mikavj/open-adaptive-switch/README.md

# Open Adaptive Switch

DIY wireless switches for iOS Switch Control, built around the Seeed XIAO
nRF52840. Each unit is a single button in a box: press it and it sends a
keystroke over Bluetooth LE, which an iPhone or iPad treats as an
accessibility switch input. The parts cost roughly $15 per unit;
comparable commercial Bluetooth switches sell for around $200.

The project started as a way to give a child with a motor disability an
affordable button for cause-and-effect games. A family can set everything
up from a phone: which key the button sends, one action or three, how
long before it sleeps, its name, and firmware updates. No computer, no
reflashing.

This is a work in progress. The firmware and configuration tools work;
enclosure designs, photos, and wiring diagrams are still to come.

## Hardware

| Part | Notes |
|---|---|
| Seeed XIAO nRF52840 | the plain variant, about $10; the Sense variant works identically |
| Tactile momentary button | wired between D0 and GND, no resistor needed |
| 3.7V 250mAh LiPo | JST connector, charged at 50mA over USB-C |
| Enclosure | can fit inside an existing adaptive switch, or check back for the 3D printed design in development |

Why this board: a BLE switch has to hold its connection all day on a
small battery. The nRF52840 does that at roughly 0.1mA, which means
months per charge; an ESP32 in its best buildable configuration draws
about twenty times more and would need charging every few days. The
whole wireless-keyboard community settled on this chip for the same
reason.

The switch works by advertising as a BLE HID keyboard. iOS pairs with it
through Settings, Accessibility, Switch Control, where any key from an
external keyboard can be assigned to a switch action. The firmware
defaults to F13, which nothing else on the system uses, so several
switches can be paired at once without colliding.

## Setting up a switch

Configuration happens over Bluetooth, from either of two clients:

**The config page**, at
[mikavj.github.io/open-adaptive-switch](https://mikavj.github.io/open-adaptive-switch/)
(source in [docs/](docs/)). Open it in Chrome or Edge on a computer or
Android device and tap Connect. On an iPhone or iPad, install the free
[Bluefy browser](https://apps.apple.com/app/id1492822055) first, then
open the page inside it - Safari does not support Web Bluetooth, and a
link into Bluefy does nothing until the app is installed. The page also
installs firmware updates and puts the first firmware on a blank board,
straight over Bluetooth. A QR code pointing at the page is in
[docs/qr](docs/qr), sized to print on the bottom of an enclosure.

**The iOS app**, in [app/](app/). A native SwiftUI app with the same
controls plus built-in firmware updates. It is not on the App Store yet;
building it yourself takes Xcode and an Apple developer account (see
[app/README.md](app/README.md)).

Either client can change:

| Setting | Choices |
|---|---|
| Mode | single key; tap or hold (two actions); short, medium, long press (three actions) |
| Keys | any HID keycode plus modifiers, per action |
| Sleep timer | minutes of inactivity before deep sleep, 0 to disable |
| Name | how the switch appears in Bluetooth lists; up to 15 plain characters |
| Status light | red, green, or blue accent |

Both show battery percentage, voltage, and charging state live, and check
this repository for firmware releases. Settings live on the switch
itself and survive restarts and updates. The switch accepts two
connections at once, so it can stay paired to the iPad while a parent
adjusts settings from a phone.

The chooser in the config page and the app only lists Open Adaptive
Switch devices (they filter on the switch's service identity), so
headphones and other Bluetooth devices never appear.

## Pairing with an iPhone or iPad

Settings, Accessibility, Switch Control, Switches, Add New Switch,
External, then press the button and assign an action.

Each distinct key registers as a separate switch input, so three-action
mode becomes three assignable switches from one physical button.

Two setups that work well in practice:

- Tap-anywhere games (tested with Peekaboo Barn): create a Switch Control
  Recipe with the action "Tap Middle of Screen" and timeout off, then
  launch the recipe. A press becomes a single screen tap with no scanner
  UI in the way.
- YouTube / Apple Music play-pause: leave Switch Control off entirely,
  set the switch to send Space, and pair it as a plain Bluetooth
  keyboard. Space toggles playback without bringing up the player
  controls.

If you reflash or rename a switch that was already paired, make iOS
Forget Device first, then pair again.

## Firmware updates

Three ways, most convenient first:

1. **Wireless, from the config page or app.** Both install updates
   directly: put the switch into update mode and the same page or app
   sends it the new firmware. Both can also flash a blank board ("Set
   up a new board"), so a switch can be built and updated without a
   computer. The blank-board flow is still experimental: some fresh
   factory boards refuse the wireless first flash. If yours does, put
   the first firmware on over USB (option 2) and update wirelessly from
   then on. A brand-new XIAO arrives running a factory demo that
   cycles the LED red, blue, green and has no Bluetooth at all;
   double-tap its reset button and the cycling stops - the LED may
   look off, which is normal - and the board is ready for "Set up a
   new board". It appears only in that flow, not in the regular switch
   list or in iOS Bluetooth settings. Nordic's free
   [nRF Device Firmware Update](https://apps.apple.com/app/id1624454660)
   app works too, with the release .zip.
2. **Any computer, no software.** Download the release .uf2, double-tap
   the switch's reset button, and a USB drive appears. Drag the file
   onto it; the switch reboots updated. (The copy dialog may report an
   error at the end - that's the drive vanishing on reboot, and the
   update still succeeded.)
3. **Wired, with the toolchain.** `./flash.sh` - it offers to install
   its own toolchain the first time it runs on a machine; see
   [SETUP.md](SETUP.md). For development and recovery; a new board can
   be set up wirelessly instead (option 1).

Settings survive all three. Releases carry the .zip and .uf2, built by
`./make_release.sh`.

## Battery

Charging is handled entirely by the XIAO's onboard BQ25101 charger IC:
50mA (a gentle 0.2C for the 250mAh cell), 4.20V termination, fixed in
hardware. A cell that measures 4.15 to 4.20V after charging is full and
healthy - 4.2V is the normal full-charge voltage for a LiPo cell.

The firmware samples the cell through the onboard divider, maps voltage
to percentage with a resting-voltage discharge table (the approach ZMK
and Meshtastic use), and reports it over the standard BLE Battery
Service - so it shows in the iOS Batteries widget - and in detail on the
config page and app. It is also put in the Bluetooth advertisement, so
the app can show a level in its device list before connecting.

Charging state comes from the charger IC's status pin, not guessed from
voltage; while charging, the percentage is capped at 99 because a
charging cell's voltage says nothing reliable about fill level. A charged
cell is held at 100 until it relaxes below 4.05V, so unplugging a full
switch doesn't drop the number. The displayed percent falls at most two
points per sample, so the inflated charging reading eases down to the
true resting value after unplugging instead of jumping, and radio-sag
transients can't make it bounce. The LED warns too: solid red below
3.55V, blinking red below 3.35V.

The firmware also protects the cell itself. If the smoothed voltage
stays below 3.30V for three consecutive samples (about a minute) while
nothing is charging, the switch blinks red and enters the same deep
sleep the inactivity timer uses. A press wakes it; if the cell is still
low it warns again and goes back to sleep. A forgotten switch therefore
cannot drain the cell toward the roughly 3.0V where LiPo damage starts.
The cutoff never fires while the charger IC reports charging or charged,
and it requires the low voltage to persist across a full minute of
samples, so the brief sag from Bluetooth transmissions cannot trigger
it. A protected cell is still good practice, but the firmware no longer
depends on its cutoff.

## Longevity

This project is built on a documented Bluetooth protocol
([docs/ble-protocol.md](docs/ble-protocol.md)) and the standard services
around it. Every client is replaceable against it: the web page, the iOS
app, Nordic's DFU tools (built on open-source libraries), and the
UF2 file copy, a file that loads off a USB drive. Anything that speaks
the protocol can drive the switch, which leaves room for future clients
and new use cases.

A current limitation on iOS requires a different browser to access the
web app; a common alternative for this application is
[Bluefy](https://apps.apple.com/app/id1492822055).
[WebBLE](https://github.com/daphtdazz/WebBLE) is an Apache-2.0
open-source browser using the same technique, and a fork restores
support.

## Status and roadmap

Working today: consolidated firmware (v3), the config page and the iOS
app, live battery reporting (including a level shown in the app's device
list before connecting), and wireless and drag-and-drop updates.

A 3D-printed case is in the works. The enclosure is being designed and
tested now, and the print and design files will be published here once
they hold up in use.

## Contributing

Issues and pull requests are welcome, and so are reports from anyone who
builds one. Useful contributions don't have to be code: testing with
different apps or devices, enclosure designs, clearer assembly docs, or
accessibility feedback from daily use all help.

## Safety notes

These are DIY devices without any certification, built around a bare LiPo
cell. Use a protected cell or handle the battery with the usual LiPo care
(no punctures, no charging unattended, replace if puffy). If you build
one for a child, make sure the enclosure is secure enough that the
battery and small parts can't be reached. The Bluetooth configuration and
update paths are open by design (see the security note in
[docs/ble-protocol.md](docs/ble-protocol.md)); anyone within radio range
could change settings, so take care where that matters.

## License

GPL-3.0-or-later. See [LICENSE](LICENSE). Firmware, page, app, scripts,
and docs are all covered; if you improve a unit, sharing the changes back
keeps the next build cheap for everyone.

So the iOS app can be offered on the Apple App Store, the copyright
holders grant an additional permission under GPL section 7 for
distribution through app stores; see
[APP-STORE-EXCEPTION.txt](APP-STORE-EXCEPTION.txt). The source stays under
the GPL and anyone can still build their own copy.
