mikavj/open-adaptive-switch/docs/qr/config-page-bluefy.png

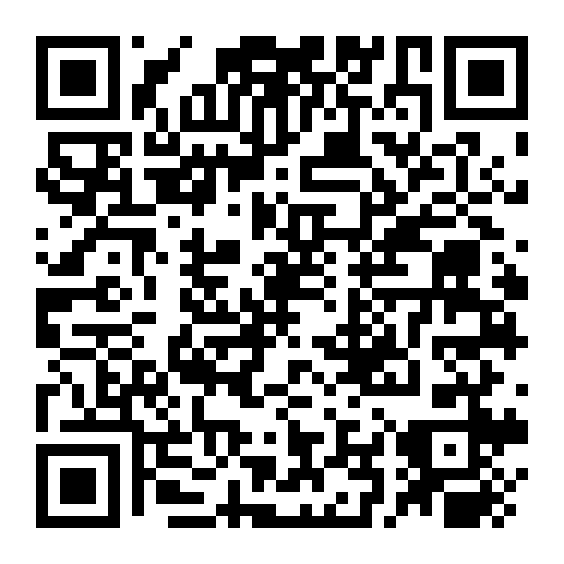
docs/qr/config-page-bluefy.png
