mikavj/open-adaptive-switch/docs/qr/config-page.png

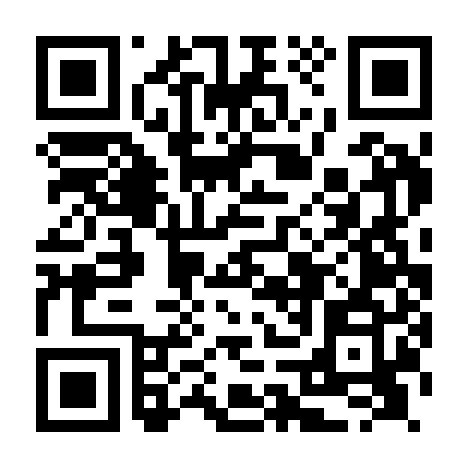
docs/qr/config-page.png
