mikavj/open-adaptive-switch/(commit log)

2026-06-12 Dev: BLE adaptive switches for iOS Switch Control
2026-07-08 v3: one firmware, phone-based configuration, OTA updates, battery fix
    [switch-firmware.ino]
2026-07-08 Plain XIAO as standard part, UF2 releases, Bluefy install flow, native iOS app
2026-07-08 v3.1.0: fix app key editing, add digits/letters, rename to Access Switch, advertise battery
    [switch-firmware.ino]
2026-07-08 v3.1.1: battery smoothing, dome color, per-device rollback + version picker, auto-update toggle, name sanitizing; rename app to OpenAdaptiveSwitch + new bundle id
2026-07-08 App Store materials: privacy policy, GPL exception, listing + review notes, 6.9" screenshots
2026-07-09 App Store: iPad screenshots, materials README
2026-07-10 Add protective low-voltage cutoff, fw 3.1.2
2026-07-12 App 1.1: remembered switches, app settings, profiles, demo switch
    Home screen keeps previously connected switches with their saved
    settings, shows when each was last seen, and marks firmware updates
    with an up arrow. New app settings screen: default configuration for
    new switches, reusable profiles, settings export/import, and data
    clearing. Device screen reorganized (inline color picker, Bluetooth
    ID, first-connection banner), name-field keyboard fixed with a Done
    bar, and a demo switch for people without hardware yet. About now
    opens openadaptiveswitch.com.
2026-07-12 App: set up a new board wirelessly from the home screen
    A blank Seeed board can now get its first firmware from the phone: the
    stock bootloader speaks the same Bluetooth update protocol the app
    already uses, so a Set up a new board option walks through double-
    tapping reset and flashing the latest release. No computer needed to
    build a switch.
2026-07-12 Config page: install firmware over Web Bluetooth, set up new boards
    The page now flashes the switch itself, speaking the bootloader's
    Nordic legacy DFU protocol - no separate DFU app. A "Set up a new
    board" section walks through first-flashing a factory-fresh Seeed
    board (double-tap reset, search, install), matching the iOS app.
    GitHub's release downloads refuse cross-origin fetches, so
    make_release.sh keeps a copy of the latest package in docs/firmware/
    for the page to serve; a downloaded .zip works as a fallback and the
    page warns when its copy is behind the newest GitHub tag.
2026-07-18 flash.sh: check and install toolchain on first run; document new-board setup
2026-07-19 Note wireless blank-board setup is experimental
